KimHyeonj00/automotive-seat-ecu/carfront/Core/Src/main.c

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
/* Includes ------------------------------------------------------------------*/
#include "main.h"

/* USER CODE BEGIN Includes */
#include "front_seat_app.h"
/* USER CODE END Includes */

CAN_HandleTypeDef hcan;

I2C_HandleTypeDef hi2c1;

TIM_HandleTypeDef htim2;

/* USER CODE BEGIN PV */
/* 애플리케이션 상태는 front_seat_app.c에서 관리한다. */
/* USER CODE END PV */

void SystemClock_Config(void);
static void MX_GPIO_Init(void);
static void MX_CAN_Init(void);
static void MX_TIM2_Init(void);
static void MX_I2C1_Init(void);
/* USER CODE BEGIN 0 */

/* ===============================
 * INA226 Continuous Current Test
 * =============================== */

#define INA226_TEST_ADDR_DRIVER       (0x40U << 1)
#define INA226_TEST_ADDR_PASSENGER    (0x41U << 1)

#define INA226_REG_SHUNT_V            0x01U
#define INA226_REG_BUS_V              0x02U
#define INA226_RSHUNT_OHM             0.1f

#define INA226_TEST_INTERVAL_MS       20U

typedef struct
{
    uint8_t valid;

    float shunt_mV;
    float bus_V;
    float current_A;

    float current_max_A;
    float current_min_A;
    float current_avg_A;
    float current_sum_A;

    float bus_min_V;

    uint32_t sample_count;
} Ina226TestData_t;

/* Watch 창에서 볼 변수 */
Ina226TestData_t ina226_driver_test;
Ina226TestData_t ina226_passenger_test;

/* Watch 창에서 1로 바꾸면 측정값 초기화됨 */
volatile uint8_t ina226_test_reset = 0U;

static uint32_t ina226_test_last_tick = 0U;

static void INA226_TestResetOne(Ina226TestData_t *d)
{
    d->valid = 0U;

    d->shunt_mV = 0.0f;
    d->bus_V = 0.0f;
    d->current_A = 0.0f;

    d->current_max_A = 0.0f;
    d->current_min_A = 99.0f;
    d->current_avg_A = 0.0f;
    d->current_sum_A = 0.0f;

    d->bus_min_V = 99.0f;

    d->sample_count = 0U;
}

static HAL_StatusTypeDef INA226_TestReadReg(uint16_t dev_addr,
                                            uint8_t reg_addr,
                                            uint16_t *value)
{
    uint8_t buf[2];

    if (value == 0)
    {
        return HAL_ERROR;
    }

    if (HAL_I2C_Mem_Read(&hi2c1,
                         dev_addr,
                         reg_addr,
                         I2C_MEMADD_SIZE_8BIT,
                         buf,
                         2U,
                         10U) != HAL_OK)
    {
        return HAL_ERROR;
    }

    *value = ((uint16_t)buf[0] << 8) | buf[1];
    return HAL_OK;
}

static void INA226_TestUpdateOne(uint16_t dev_addr, Ina226TestData_t *d)
{
    uint16_t raw_shunt;
    uint16_t raw_bus;
    int16_t signed_shunt;

    if (INA226_TestReadReg(dev_addr, INA226_REG_SHUNT_V, &raw_shunt) != HAL_OK)
    {
        d->valid = 0U;
        return;
    }

    if (INA226_TestReadReg(dev_addr, INA226_REG_BUS_V, &raw_bus) != HAL_OK)
    {
        d->valid = 0U;
        return;
    }

    signed_shunt = (int16_t)raw_shunt;

    d->shunt_mV = (float)signed_shunt * 0.0025f;
    d->bus_V = (float)raw_bus * 0.00125f;

    d->current_A = (d->shunt_mV / 1000.0f) / INA226_RSHUNT_OHM;

    if (d->current_A < 0.0f)
    {
        d->current_A = -d->current_A;
    }

    d->valid = 1U;

    d->sample_count++;
    d->current_sum_A += d->current_A;
    d->current_avg_A = d->current_sum_A / (float)d->sample_count;

    if (d->current_A > d->current_max_A)
    {
        d->current_max_A = d->current_A;
    }

    if (d->current_A < d->current_min_A)
    {
        d->current_min_A = d->current_A;
    }

    if (d->bus_V < d->bus_min_V)
    {
        d->bus_min_V = d->bus_V;
    }
}

static void INA226_CurrentTest_Process(void)
{
    uint32_t now = HAL_GetTick();

    if (ina226_test_reset != 0U)
    {
        ina226_test_reset = 0U;
        INA226_TestResetOne(&ina226_driver_test);
        INA226_TestResetOne(&ina226_passenger_test);
    }

    if ((now - ina226_test_last_tick) < INA226_TEST_INTERVAL_MS)
    {
        return;
    }

    ina226_test_last_tick = now;

    INA226_TestUpdateOne(INA226_TEST_ADDR_DRIVER, &ina226_driver_test);
    INA226_TestUpdateOne(INA226_TEST_ADDR_PASSENGER, &ina226_passenger_test);
}

/* USER CODE END 0 */

/**
  * @brief  The application entry point.
  * @retval int
  */
int main(void)
{

  /* MCU Configuration--------------------------------------------------------*/

  /* Reset of all peripherals, Initializes the Flash interface and the Systick. */
  HAL_Init();

  /* Configure the system clock */
  SystemClock_Config();

  /* Initialize all configured peripherals */
  MX_GPIO_Init();
  MX_CAN_Init();
  MX_TIM2_Init();
  MX_I2C1_Init();
  /* USER CODE BEGIN 2 */
  FrontSeatApp_Init(&hi2c1);
  /* USER CODE END 2 */

  /* Infinite loop */
  /* USER CODE BEGIN WHILE */
  while (1)
  {

    /* USER CODE END WHILE */

    /* USER CODE BEGIN 3 */
    FrontSeatApp_Process();

    /* 실제 끼임 복구 동작 테스트할 때는 측정용 I2C 읽기를 끈다. */
    // INA226_CurrentTest_Process();
  }
  /* USER CODE END 3 */
}

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
