KimHyeonj00/automotive-seat-ecu/(commit log)

2026-10-04 Rename 자동차 플젝 전체 시스템 구조도.png to system_architecture.png
2026-10-04 Rename 끼임감지 FSM 구조도.png to anti_pinch_FSM.png
